SSS-Controls/URC_Control_Board_v1/single_board/single_board.kicad_pcb

## KiCad design single_board/single_board.kicad_pcb (2026-10-24)

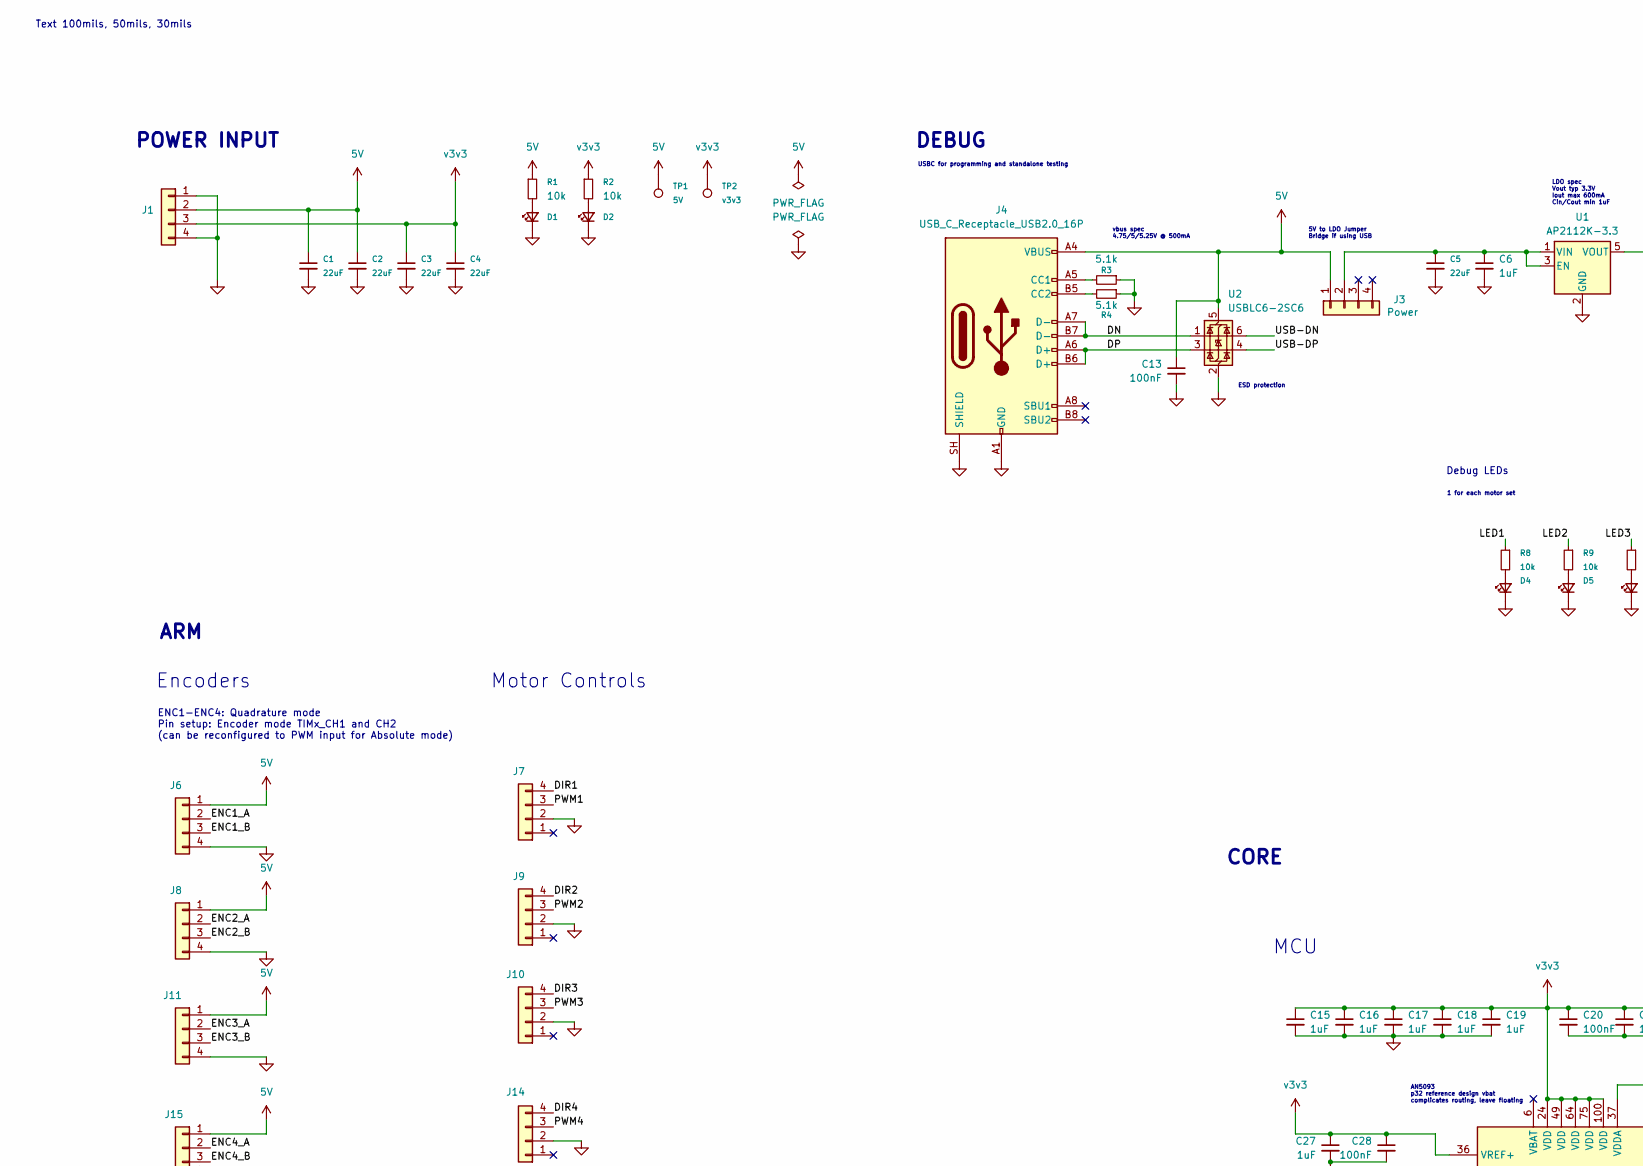
[picture p1: schematic single_board.kicad_sch, part in row 1, column 1]

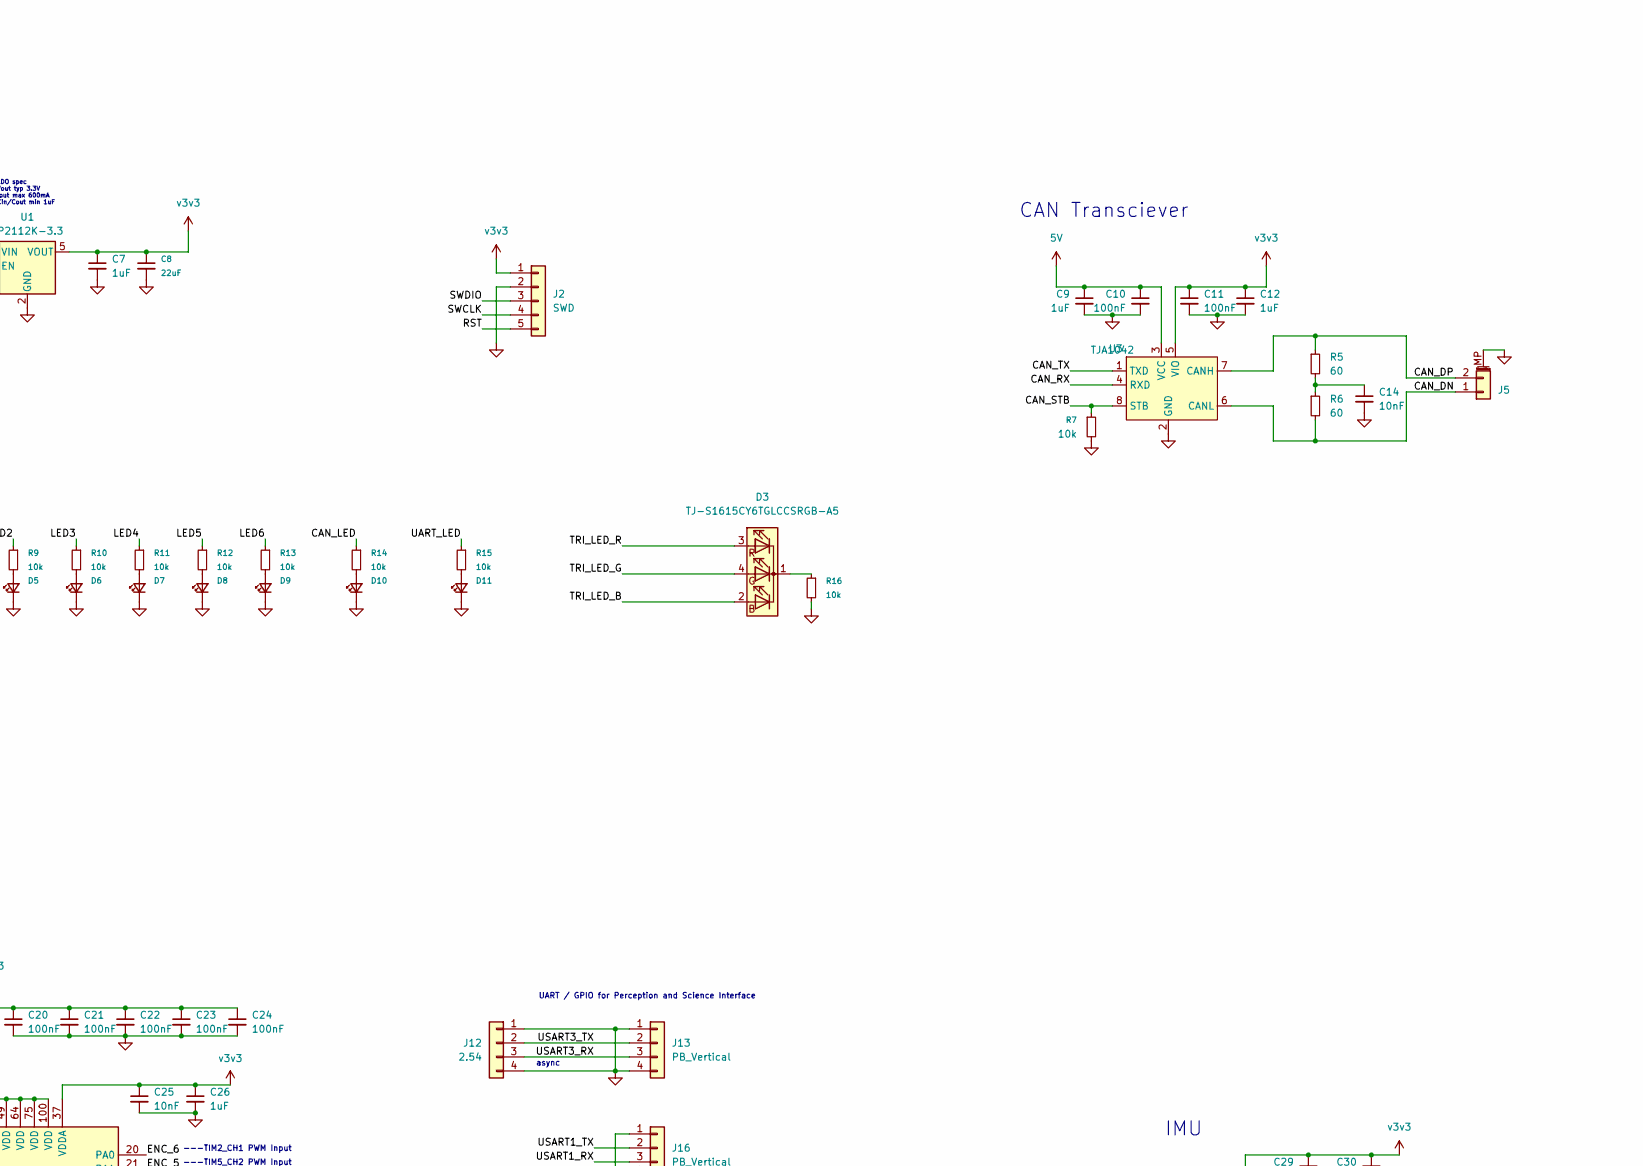
[picture p2: schematic single_board.kicad_sch, part in row 1, column 2]

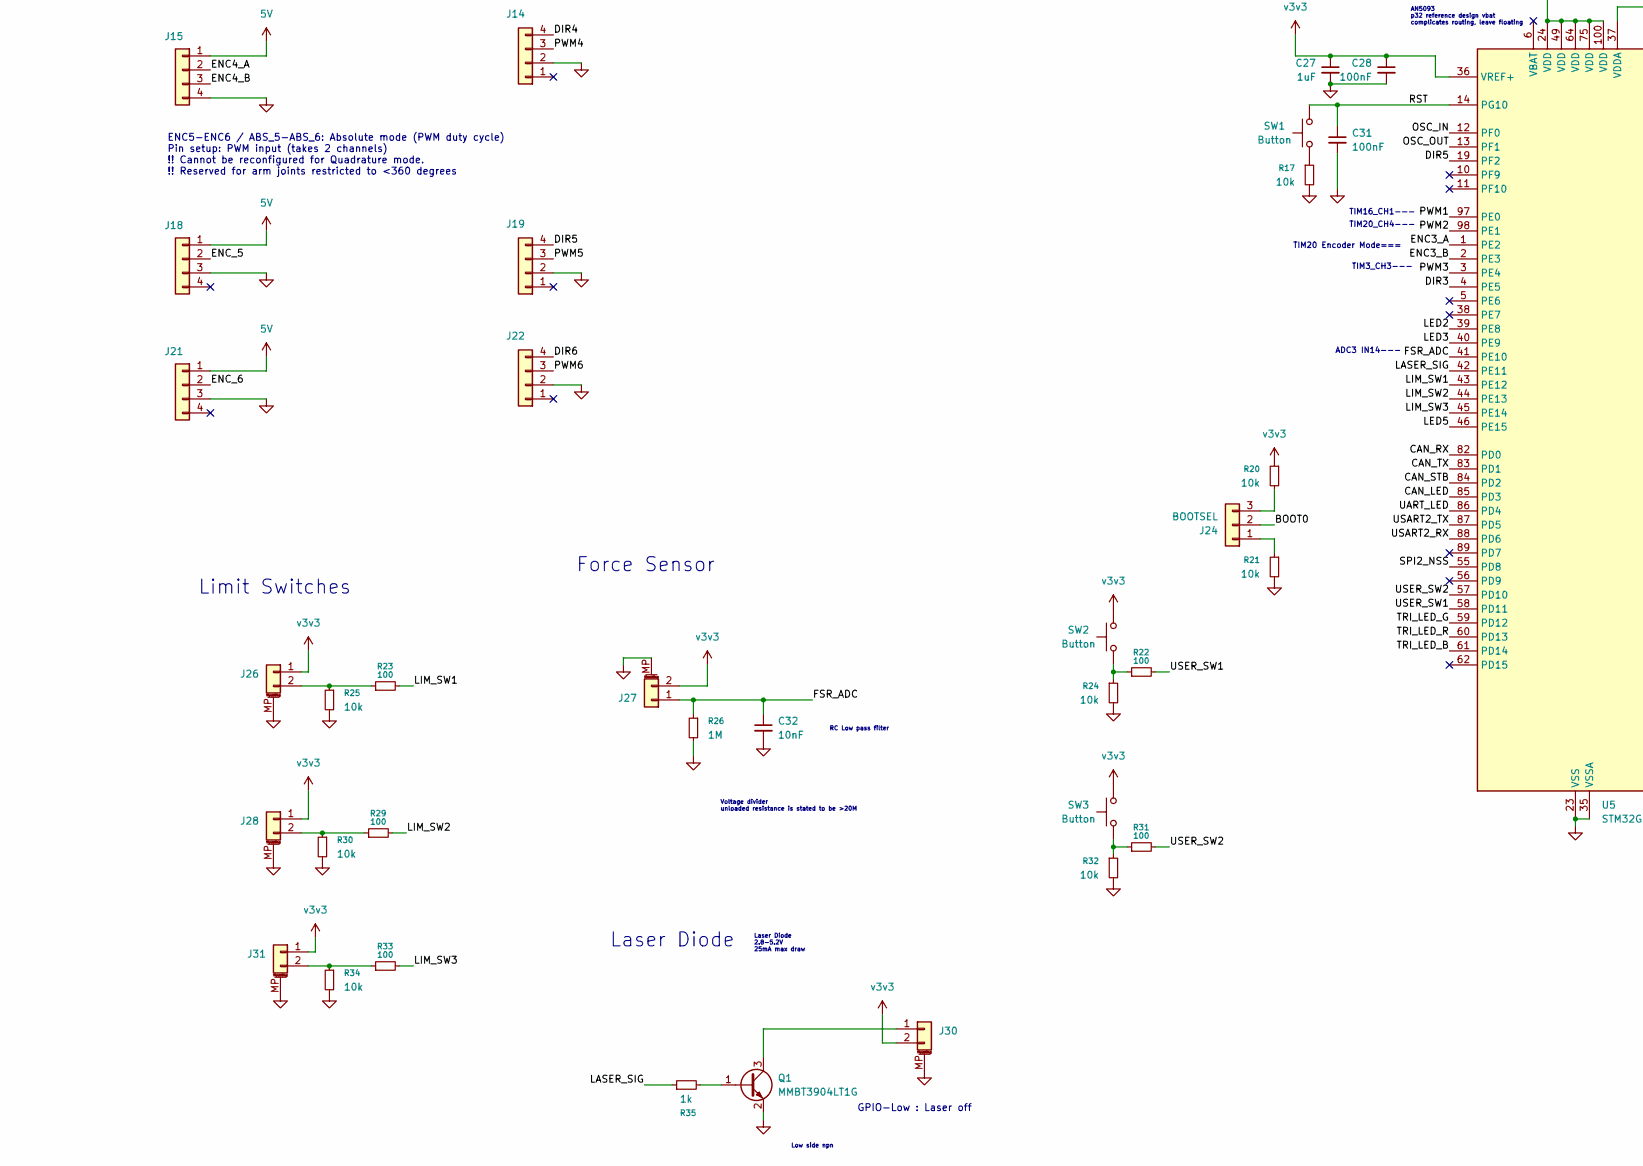
[picture p3: schematic single_board.kicad_sch, part in row 2, column 1]

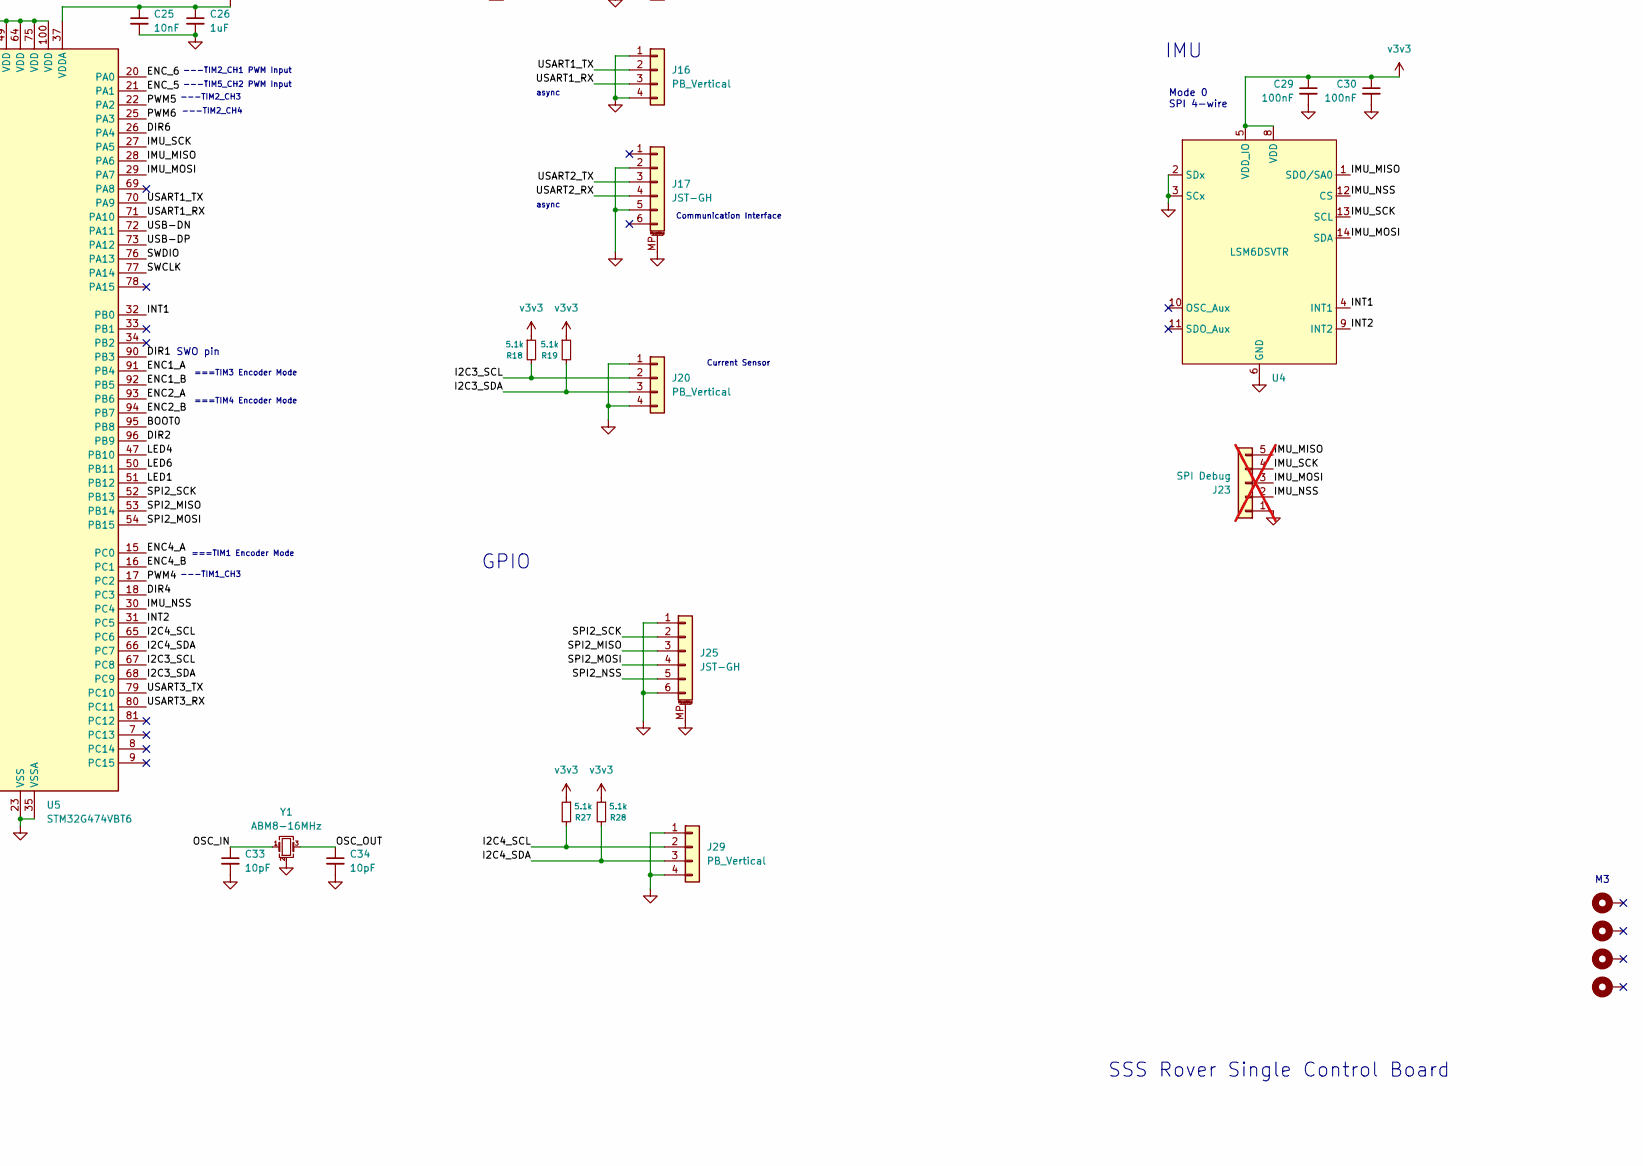
[picture p4: schematic single_board.kicad_sch, part in row 2, column 2]

Parts:
C1, C2, C3, C4, C5, C8: 22uF; C_0805_2012Metric; LCSC Part # C602037
C6, C7, C9, C12, C15, C16, C17, C18, C19, C26, C27: 1uF; C_0402_1005Metric; LCSC Part # C52923
C10, C11, C13, C20, C21, C22, C23, C24, C28, C29, C30, C31: 100nF; C_0402_1005Metric; LCSC Part # C100072
C14, C25, C32: 10nF; C_0402_1005Metric; LCSC Part # C15195
C33, C34: 10pF; C_0402_1005Metric; LCSC Part # C76946
D1, D2: LED_Small; LED_0603_1608Metric; LCSC Part # C5160697
D3: TJ-S1615CY6TGLCCSRGB-A5; TOGAILED; LCSC Part # C601684
D4, D5, D6, D7, D8, D9, D10, D11: LED; LED_0603_1608Metric; LCSC Part # C5160697
H1, H2, H3, H4: M3; MountingHole_3.2mm_M3_Pad
J1, J6, J7, J8, J9, J10, J11, J13, J14, J15, J16, J18, J19, J20, J21, J22, J29: PB_Vertical; Molex_PicoBlade_53047-0410_1x04_P1.25mm_Vertical; LCSC Part # C504989
J2: SWD; PinHeader_1x05_P2.54mm_Vertical
J3: Power; PinHeader_1x04_P2.54mm_Vertical
J4: USB_C_Receptacle_USB2.0_16P; USB_C_Receptacle_HRO_TYPE-C-31-M-12; LCSC Part # C165948
J5, J26, J27, J28, J30, J31: JST_GH; JST_GH_SM02B-GHS-TB_1x02-1MP_P1.25mm_Horizontal; LCSC Part # C189893
J12: 2.54; 2.54 SMD
J17, J25: JST-GH; JST_GH_SM06B-GHS-TB_1x06-1MP_P1.25mm_Horizontal; LCSC Part # C133065
J23: SPI Debug; PinHeader_1x05_P1.27mm_Vertical; not fitted
J24: BOOTSEL; PinHeader_1x03_P2.54mm_Vertical
Q1: MMBT3904LT1G; SOT-23; LCSC Part # C81464
R1, R2, R7, R8, R9, R10, R11, R12, R13, R14, R15, R16, R17, R20, R21, R24, R25, R30, R32, R34: 10k; R_0402_1005Metric; LCSC Part # C71617
R3, R4, R18, R19, R27, R28: 5.1k; R_0402_1005Metric; LCSC Part # C105872
R5, R6: 60; R_0402_1005Metric; LCSC Part # C416565
R22, R23, R29, R31, R33: 100; R_0402_1005Metric; LCSC Part # C413063
R26: 1M; R_0402_1005Metric; LCSC Part # C26083
R35: 1k; R_0402_1005Metric
SW1, SW2, SW3: Button; SW_SPST_PTS810; LCSC Part # C221897
TP1: 5V; TestPoint_Pad_D1.5mm
TP2: v3v3; TestPoint_Pad_D1.5mm
U1: AP2112K-3.3; SOT-23-5; LCSC Part # C51118
U2: USBLC6-2SC6; SOT-23-6; LCSC Part # C7519
U3: TJA1042; SOIC-8_3.9x4.9mm_P1.27mm; LCSC Part # C53670
U4: LSM6DSVTR; LSM6DSV; LCSC Part # C5267399
U5: STM32G474VBT6; LQFP-100_14x14mm_P0.5mm; LCSC Part # C730130
Y1: ABM8-16MHz; Crystal_SMD_Abracon_ABM8G-4Pin_3.2x2.5mm; LCSC Part # C179641

Connections:
5V: C1.1, C2.1, C9.1, C10.1, C13.1, J1.2, J3.1, J4.A4 (VBUS), J4.A9 (VBUS), J4.B4 (VBUS), J4.B9 (VBUS), J6.1, J8.1, J11.1, J15.1, J18.1, J21.1, R1.1, TP1.1 (1_1), U2.5 (VBUS), U3.3 (VCC)
/BOOT0: J24.2, U5.95 (PB8)
/CAN_DN: J5.1, R6.2, U3.6 (CANL)
/CAN_DP: J5.2, R5.1, U3.7 (CANH)
/CAN_LED: R14.1, U5.85 (PD3)
/CAN_RX: U3.4 (RXD), U5.82 (PD0)
/CAN_STB: R7.1, U3.8 (STB), U5.84 (PD2)
/CAN_TX: U3.1 (TXD), U5.83 (PD1)
/DIR1: J7.4, U5.90 (PB3)
/DIR2: J9.4, U5.96 (PB9)
/DIR3: J10.4, U5.4 (PE5)
/DIR4: J14.4, U5.18 (PC3)
/DIR5: J19.4, U5.19 (PF2)
/DIR6: J22.4, U5.26 (PA4)
/DN: J4.A7 (D-), J4.B7 (D-), U2.1 (I/O1)
/DP: J4.A6 (D+), J4.B6 (D+), U2.3 (I/O2)
/ENC1_A: J6.2, U5.91 (PB4)
/ENC1_B: J6.3, U5.92 (PB5)
/ENC2_A: J8.2, U5.93 (PB6)
/ENC2_B: J8.3, U5.94 (PB7)
/ENC3_A: J11.2, U5.1 (PE2)
/ENC3_B: J11.3, U5.2 (PE3)
/ENC4_A: J15.2, U5.15 (PC0)
/ENC4_B: J15.3, U5.16 (PC1)
/ENC_5: J18.2, U5.21 (PA1)
/ENC_6: J21.2, U5.20 (PA0)
/FSR_ADC: C32.1, J27.1, R26.1, U5.41 (PE10)
/I2C3_SCL: J20.2, R18.2, U5.67 (PC8)
/I2C3_SDA: J20.3, R19.2, U5.68 (PC9)
/I2C4_SCL: J29.2, R27.2, U5.65 (PC6)
/I2C4_SDA: J29.3, R28.2, U5.66 (PC7)
/IMU_MISO: J23.5, U4.1 (SDO/SA0), U5.28 (PA6)
/IMU_MOSI: J23.3, U4.14 (SDA), U5.29 (PA7)
/IMU_NSS: J23.2, U4.12 (CS), U5.30 (PC4)
/IMU_SCK: J23.4, U4.13 (SCL), U5.27 (PA5)
/INT1: U4.4 (INT1), U5.32 (PB0)
/INT2: U4.9 (INT2), U5.31 (PC5)
/LASER_SIG: R35.1, U5.42 (PE11)
/LED1: R8.1, U5.51 (PB12)
/LED2: R9.1, U5.39 (PE8)
/LED3: R10.1, U5.40 (PE9)
/LED4: R11.1, U5.47 (PB10)
/LED5: R12.1, U5.46 (PE15)
/LED6: R13.1, U5.50 (PB11)
/LIM_SW1: R23.2, U5.43 (PE12)
/LIM_SW2: R29.2, U5.44 (PE13)
/LIM_SW3: R33.2, U5.45 (PE14)
/OSC_IN: C33.1, U5.12 (PF0), Y1.1
/OSC_OUT: C34.1, U5.13 (PF1), Y1.3
/PWM1: J7.3, U5.97 (PE0)
/PWM2: J9.3, U5.98 (PE1)
/PWM3: J10.3, U5.3 (PE4)
/PWM4: J14.3, U5.17 (PC2)
/PWM5: J19.3, U5.22 (PA2)
/PWM6: J22.3, U5.25 (PA3)
/RST: C31.1, J2.5, SW1.2, U5.14 (PG10)
/SPI2_MISO: J25.3, U5.53 (PB14)
/SPI2_MOSI: J25.4, U5.54 (PB15)
/SPI2_NSS: J25.5, U5.55 (PD8)
/SPI2_SCK: J25.2, U5.52 (PB13)
/SWCLK: J2.4, U5.77 (PA14)
/SWDIO: J2.3, U5.76 (PA13)
/TRI_LED_B: D3.2 (BA), U5.61 (PD14)
/TRI_LED_G: D3.4 (GA), U5.59 (PD12)
/TRI_LED_R: D3.3 (RA), U5.60 (PD13)
/UART_LED: R15.1, U5.86 (PD4)
/USART1_RX: J16.3, U5.71 (PA10)
/USART1_TX: J16.2, U5.70 (PA9)
/USART2_RX: J17.4, U5.88 (PD6)
/USART2_TX: J17.3, U5.87 (PD5)
/USART3_RX: J12.3, J13.3, U5.80 (PC11)
/USART3_TX: J12.2, J13.2, U5.79 (PC10)
/USB-DN: U2.6 (I/O1), U5.72 (PA11)
/USB-DP: U2.4 (I/O2), U5.73 (PA12)
/USER_SW1: R22.2, U5.58 (PD11)
/USER_SW2: R31.2, U5.57 (PD10)
GND: C1.2, C2.2, C3.2, C4.2, C5.2, C6.2, C7.2, C8.2, C9.2, C10.2, C11.2, C12.2, C13.2, C14.2, C15.2, C16.2, C17.2, C18.2, C19.2, C20.2, C21.2, C22.2, C23.2, C24.2, C25.2, C26.2, C27.2, C28.2, C29.2, C30.2, C31.2, C32.2, C33.2, C34.2, D1.1 (K), D2.1 (K), D4.1 (K), D5.1 (K), D6.1 (K), D7.1 (K), D8.1 (K), D9.1 (K), D10.1 (K), D11.1 (K), J1.1, J1.4, J2.2, J4.A1 (GND), J4.A12 (GND), J4.B1 (GND), J4.B12 (GND), J4.SH (SHIELD), J5.MP (MountPin), J6.4, J7.2, J8.4, J9.2, J10.2, J11.4, J12.1, J12.4, J13.1, J13.4, J14.2, J15.4, J16.1, J16.4, J17.2, J17.5, J17.MP (MountPin), J18.3, J19.2, J20.1, J20.4, J21.3, J22.2, J23.1, J25.1, J25.6, J25.MP (MountPin), J26.MP (MountPin), J27.MP (MountPin), J28.MP (MountPin), J29.1, J29.4, J30.MP (MountPin), J31.MP (MountPin), Q1.2 (E), R3.1, R4.1, R7.2, R16.2, R17.2, R21.2, R24.2, R25.2, R26.2, R30.2, R32.2, R34.2, U1.2 (GND), U2.2 (GND), U3.2 (GND), U4.2 (SDx), U4.3 (SCx), U4.6 (GND), U4.7 (GND), U5.23 (VSS), U5.35 (VSSA), U5.48 (VSS), U5.63 (VSS), U5.74 (VSS), U5.99 (VSS), Y1.2 (G), Y1.4 (G)
unnamed: C14.1, R5.2, R6.1
unnamed: D1.2 (A), R1.2
unnamed: D2.2 (A), R2.2
unnamed: D3.1 (K), R16.1
unnamed: D4.2 (A), R8.2
unnamed: D5.2 (A), R9.2
unnamed: D6.2 (A), R10.2
unnamed: D7.2 (A), R11.2
unnamed: D8.2 (A), R12.2
unnamed: D9.2 (A), R13.2
unnamed: D10.2 (A), R14.2
unnamed: D11.2 (A), R15.2
unnamed: C5.1, C6.1, J3.2, U1.1 (VIN), U1.3 (EN)
unnamed: J4.A5 (CC1), R3.2
unnamed: J4.B5 (CC2), R4.2
unnamed: J24.1, R21.1
unnamed: J24.3, R20.2
unnamed: J26.2, R23.1, R25.1
unnamed: J28.2, R29.1, R30.1
unnamed: J30.1, Q1.3 (C)
unnamed: J31.2, R33.1, R34.1
unnamed: Q1.1 (B), R35.2
unnamed: R17.1, SW1.1
unnamed: R22.1, R24.1, SW2.1
unnamed: R31.1, R32.1, SW3.1
v3v3: C3.1, C4.1, C7.1, C8.1, C11.1, C12.1, C15.1, C16.1, C17.1, C18.1, C19.1, C20.1, C21.1, C22.1, C23.1, C24.1, C25.1, C26.1, C27.1, C28.1, C29.1, C30.1, J1.3, J2.1, J26.1, J27.2, J28.1, J30.2, J31.1, R2.1, R18.1, R19.1, R20.1, R27.1, R28.1, SW2.2, SW3.2, TP2.1 (1_1), U1.5 (VOUT), U3.5 (VIO), U4.5 (VDD_IO), U4.8 (VDD), U5.24 (VDD), U5.36 (VREF+), U5.37 (VDDA), U5.49 (VDD), U5.64 (VDD), U5.75 (VDD), U5.100 (VDD)

Notes on the sheet:
---TIM2_CH4
Mode 0 SPI 4-wire
Voltage divider unloaded resistance is stated to be >20M
ENC1-ENC4: Quadrature mode Pin setup: Encoder mode TIMx_CH1 and CH2 (can be reconfigured to PWM input for Absolute mode)
1 for each motor set
Text 100mils, 50mils, 30mils
SSS Rover Single Control Board
Low side npn
GPIO-Low : Laser off
===TIM4 Encoder Mode
IMU
UART / GPIO for Perception and Science Interface
TIM3_CH3---
AN5093 p32 reference design vbat complicates routing, leave floating
Limit Switches
POWER INPUT
Laser Diode 2.8-5.2V 25mA max draw
MCU
Debug LEDs
async
5V to LDO Jumper Bridge if using USB
TIM20_CH4---
ESD protection
Communication Interface
RC Low pass filter
---TIM2_CH3
SWO pin
Encoders
ENC5-ENC6 / ABS_5-ABS_6: Absolute mode (PWM duty cycle) Pin setup: PWM input (takes 2 channels) !! Cannot be reconfigured for Quadrature mode. !! Reserved for arm joints restricted to <360 degrees
---TIM2_CH1 PWM Input
DEBUG
LDO spec Vout typ 3.3V Iout max 600mA Cin/Cout min 1uF
Current Sensor
ARM
USBC for programming and standalone testing
===TIM3 Encoder Mode
GPIO
TIM20 Encoder Mode===
vbus spec 4.75/5/5.25V @ 500mA
Laser Diode
TIM16_CH1---
CAN Transciever
ADC3 IN14---
CORE
===TIM1 Encoder Mode
---TIM5_CH2 PWM Input
Motor Controls
---TIM1_CH3
Force Sensor

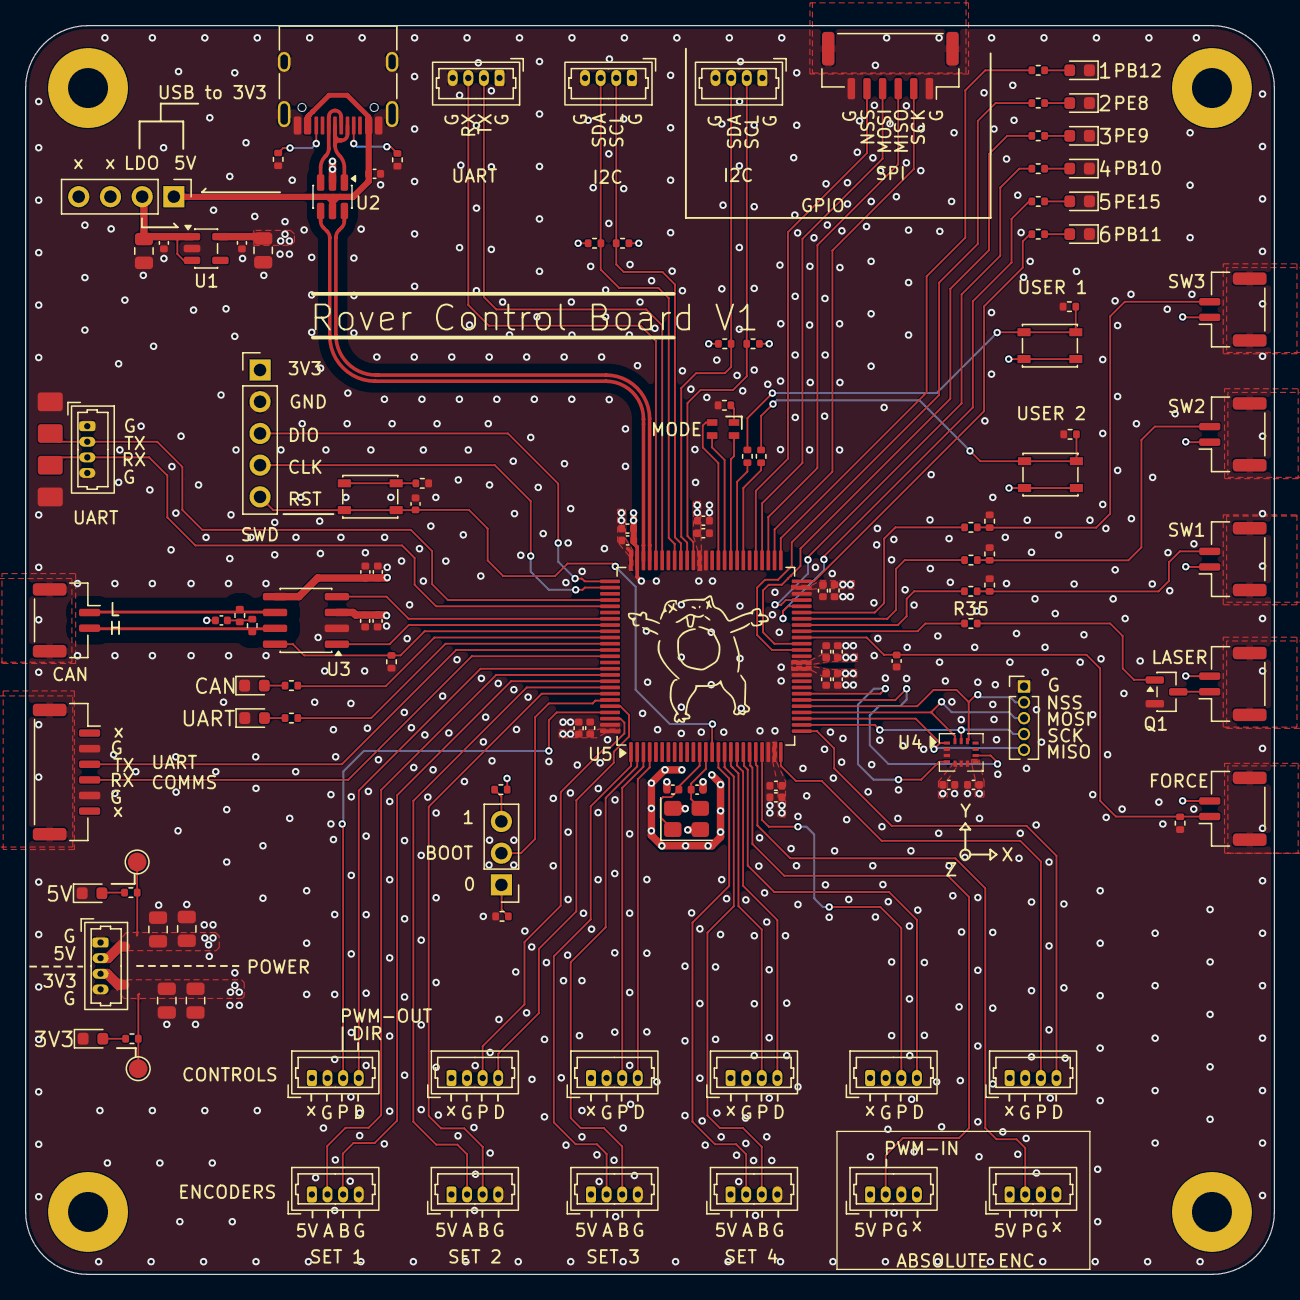
[picture p5: board single_board.kicad_pcb from above]

Board: 4 copper layers, 100.0 x 100.0 mm, 127 parts (0 on the bottom side), 103 nets.
