SSS-Controls/URC_Control_Board_v1/(commit log)

2026-10-04 Update Footprints
    Adjust dimensions from hand solder to datasheet recommendations
2026-10-04 Update Footprint References
2026-10-04 Update footprints in project files
    [single_board.kicad_pcb, single_board.kicad_sch]
2026-10-04 Zener diode footprint
    Symbol pins 1 and 2 mapped to correct footprint position on default SOT-23
2026-10-04 Reset Pin to 1x02
    [single_board.kicad_pcb, single_board.kicad_sch]
2026-10-08 Schematic Changes
    HSE 16 MHz
    Major Pinout Change
    Fix 5V LDO jumper topology
    Change Mode LED
    Encoder type split
2026-10-09 LDO Power Jumper
    Improved topology and usability
2026-10-09 Limit switch topology
2026-10-10 Tri color LED resistors
2026-10-10 Routing IMU
2026-10-11 Silkscreen on LEDs
2026-10-11 UART Connector
2026-10-11 Arm Motor Silkscreen
2026-10-11 Routing I2C
2026-10-11 Encoder Routing
2026-10-11 Front Silkscreen
2026-10-11 Back Silkscreen
2026-10-11 Fix SPI debug pin labels
2026-10-11 2 User buttons
2026-10-15 Mode LED resistor fix
2026-10-16 Remove components
    Remove zener diode, pmos
    Optimize CAN and power connector
    Vias under MCU for better grounding
    Fix back silkscreen
2026-10-18 Minor changes
    going through bom
2026-10-24 Label SWO
    Label SWO in schematic
    Label SWO in pcb editor, user comments
    PB3
2026-10-25 Specify IMU
    LSM6DSRXTR
